JamieKitson/PiFrame/Images/voltagePlot.png

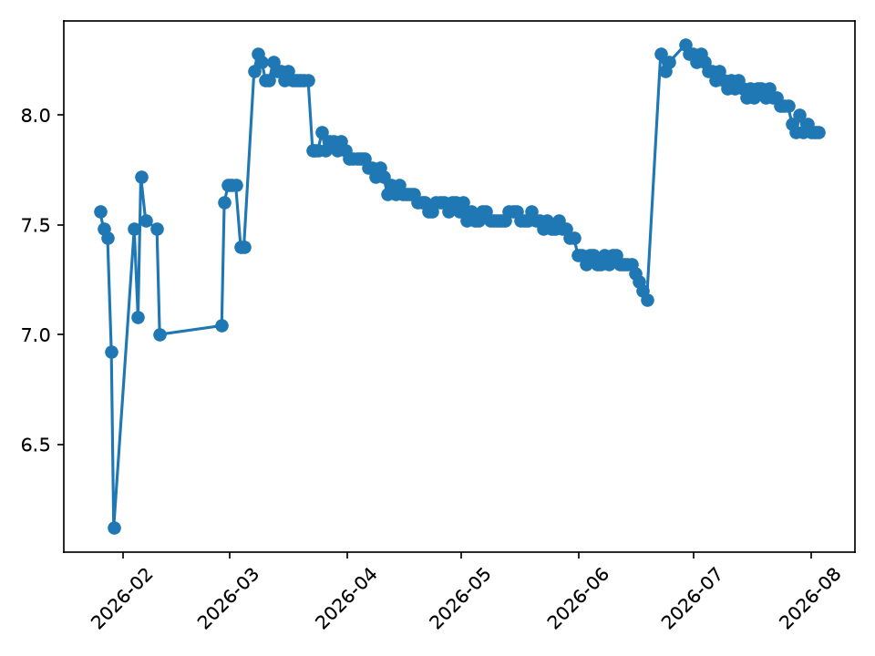
Images/voltagePlot.png
