JamieKitson/PiFrame/(commit log)

2026-01-22 LED Status
2026-01-22 LED Status - fix compile errors
    [fullFrame.ino]
2026-01-23 fix LED status
2026-01-25 read after shutdown, update LED on shutdown
2026-01-26 debounce arduino button
2026-01-27 fix minutes, add blinking and pauses for startup debugging
    [fullFrame.ino]
2026-01-27 update button press wait, reset button press on update
2026-01-28 Move set timer alarm to pi python script
2026-01-29 Remove Arduino RTC code
2026-02-04 Write own methods for disabling RTC 32khz output to save lots of battery
2026-02-05 test battery level notifications
2026-02-05 fix mail => s-nail
    [imagesd.py]
2026-02-05 low voltage notifications
2026-02-06 Revert "minor refactoring"
    This reverts commit fe943222fc21ec27d08e616dcfba524317cfecdc.
    [imagesd.py]
2026-02-06 Revert "refactoring"
    This reverts commit 6302bc0db69869aed7c3fbac593e0773c99e0390.
    [imagesd.py]
2026-02-09 stop borking I2C on arduino button press
2026-02-10 i2c class
2026-03-07 Revert "minor refactor"
    This reverts commit 607c7906d57205c526a4272b9a363d67e94e9e2d.
    [imagesd.py]
2026-03-07 Gracefully restart python script to try to avoid locking I2C on button press
    [imagesd.py]
2026-03-07 I2C read+write in single transaction
2026-03-07 Revert "I2C read+write in single transaction"
    This reverts commit eae7ce5b411b8af94ed02004a0ef2226c497576d.
    [imagesd.py]
2026-03-07 Revert "Gracefully restart python script to try to avoid locking I2C on button press"
    This reverts commit 1ffa9c02beacbe207f84fbac2e8e7f133d59eea6.
    [imagesd.py]
2026-03-07 Revert "Revert "minor refactor""
    This reverts commit de875ef2fe5ac34f9b2ffddae5f0553e641ca626.
    [imagesd.py]
2026-04-21 Rename Circuit.png to CircuitPhoto.png
    Updated the image in the README from Circuit.png to CircuitPhoto.png.
2026-04-21 Revert removing circuit photo content
2026-04-21 Circuit sketch
2026-04-21 Circuit sketch svg
2026-05-01 graph voltage
2026-08-03 plot voltage update
2026-09-14 Try to reset i2c lines, shut off power to pi after five minutes as fail safe.
    [fullFrame.ino, imagesd.py]
2026-09-14 Fix flashing LED while power off. Add delay for emailing log.
    [fullFrame.ino]
2026-10-28 don't log image when voltage param not supplied
2026-10-29 another attempt at unblocking i2c
2026-11-02 minor arduino script fix
